oliBrowne/swing-to-mine/docs/architecture.md

# Architecture

How Swing to Mine fits together. This is the **plan**, not a description of finished code: modules listed here may not exist yet. Check each folder's README for status.

## System overview

```mermaid
flowchart LR
    subgraph Handle["Sword handle"]
        IMU["MPU-6050<br/>accel + gyro<br/>100 Hz"]
        BTN["Blue button"]
        LED["4 LEDs"]
    end
    subgraph MCU["STM32F407 firmware"]
        DRV["imu driver<br/>+ calibration"]
        RB["ring buffer<br/>1 s x 6 ch"]
        NN["model runner<br/>int8 CNN"]
        DEC["gesture decoder<br/>thresholds, cooldowns"]
        AIR["air mouse<br/>yaw + pitch"]
        WALK["tilt walk<br/>pitch + roll"]
        MODE["mode manager<br/>LOOK / MOVE / INVENTORY"]
        HID["HID out<br/>keyboard + mouse"]
        CDC["USB serial<br/>data + debug"]
    end
    PC["PC running<br/>Minecraft Java"]
    HOST["host scripts<br/>record, plot"]

    IMU --> DRV --> RB --> NN --> DEC --> MODE
    DRV --> AIR --> MODE
    DRV --> WALK --> MODE
    BTN --> MODE --> LED
    MODE --> HID -->|USB HID| PC
    DRV --> CDC -->|USB serial| HOST
```

Two paths run side by side every sample:

- **ML path:** a sliding window goes through the int8 CNN every 50 ms, and the decoder turns class probabilities into game events (click, hold, jump, scroll, `E`).
- **Direct path:** the gyro and accelerometer drive looking (air mouse) and walking (tilt) with plain math, no ML.

The **mode manager** decides which outputs are live and merges everything into one HID report.

## Modes

```mermaid
stateDiagram-v2
    [*] --> CALIBRATE: power on
    CALIBRATE --> LOOK: still for 2 s
    LOOK --> MOVE: single press
    MOVE --> LOOK: single press
    LOOK --> INVENTORY: hold 1 s (sends E)
    MOVE --> INVENTORY: hold 1 s (sends E)
    INVENTORY --> LOOK: hold 1 s (sends E), back to the last play mode
    INVENTORY --> MOVE: hold 1 s (sends E), back to the last play mode
```

The full control table (every motion and button action per mode), LEDs and the state the firmware tracks: [controls.md](controls.md#quick-reference).

| Mode | Air mouse | Tilt walk | Gestures | LED |
|---|---|---|---|---|
| CALIBRATE | off | off | off | spinning |
| LOOK | left/right + up/down → camera | off | all | green |
| MOVE | left/right only → camera (steering) | tilt from neutral → `WASD` + sprint ([controls.md](controls.md#move-mode-walking-and-sprinting)) | off | orange |
| INVENTORY | left/right + up/down → cursor, low gain | off | paused (button = left click) | blue |

Rules in every mode:

- **Pointing is rate-based, like a Wii remote:** slow rotation moves the camera, a dead zone hides hand shake, and fast rotation freezes the camera because it's probably a gesture ([controls.md](controls.md#pointing-look-mode-and-inventory)). Left/right is turning around the vertical (found from gravity), since the board is held upright.
- **Changing mode releases every held key and click.** Crouch is a `Shift` tap with Minecraft's Sneak set to Toggle, so nothing is held for it ([controls.md](controls.md#crouch)).
- **Rest pose** (board flat or face-down and still for >1 s) pauses all output; the current mode's LED breathes ([LEDs](controls.md#leds)).

## Gestures → game events

| Model class | Motion | Decoder output |
|---|---|---|
| `nothing` | anything else, including slow pointing/looking, resting, fidgeting | none |
| `sword` | side swipe, like swinging a sword | one left click |
| `mine` | continuous chopping (repeated pickaxe swings) | **hold** left click |
| `place` | straight jab forward, no tilt | right click (place block, open chest) |
| `swap_left` | quick hotbar flick to the left | scroll up (one hotbar slot left) |
| `swap_right` | quick hotbar flick to the right | scroll down (one hotbar slot right) |

The model only covers **look mode**. Jump (an upward flick in move mode) and the movement tilts are simple rules in the firmware, so they aren't recorded or trained. Shake was dropped (the button opens the inventory).

**Mine hold logic** (in the decoder, not the model): the model runs continuously on a sliding window, so while you keep chopping it keeps outputting `mine`. The first `mine` starts holding left click; another `mine` within ~600 ms keeps it held; the hold releases after ~400 ms with no more. The camera stays frozen while holding, so the crosshair doesn't drift off the block. A `sword` is a single click and never holds.

Recordings made before Nov 13 used the old names `slash`, `chop`, `punch` (now `sword`, `mine`, `place`); `training/labels.py` has the mapping. Old `hop` and `shake` labels are skipped.

## Timing budget

| Stage | Plan |
|---|---|
| Sampling | 100 Hz, MPU-6050 data-ready interrupt (or its FIFO) |
| Window | 100 samples = 1.0 s, 6 channels |
| Stride | 5 samples = 50 ms (20 inferences/s) |
| Inference | target < 5 ms on the Cortex-M4 |
| Decoder | needs 2–3 agreeing frames → adds 50–100 ms |
| USB | HID poll every 1 ms |
| Air mouse delay | output held back ~60 ms so a starting gesture can cancel it |
| **Target** | **≤ ~100 ms from the gesture's peak to the input** |

Measure with GPIO toggles on a logic analyzer/scope (or 240 fps video), and the DWT cycle counter for inference.

## Memory budget (STM32F407VG: 1 MB flash, 128 KB RAM + 64 KB CCM)

| Item | Estimate |
|---|---|
| Firmware + USB stack | ~60 KB flash |
| Inference runtime (ExecuTorch) | ~50–150 KB flash (unknown: measure early) |
| Model weights (int8) | < 50 KB flash |
| Window buffer | 100 × 6 × int16 = 1.2 KB RAM |
| Model activations | < 32 KB RAM |

DMA can't reach CCM, so keep USB and I2C DMA buffers in normal RAM.

## Interfaces (contracts between parts)

These are the agreements that let firmware, host and training be built in parallel. Change them only with the whole team.

### Sensor units

Raw MPU-6050 counts as `int16`, accel ±16 g (2048 counts/g), gyro ±2000 °/s (16.4 counts per °/s). Axes are the **sensor's** axes; the handle fixes the orientation (see [hardware.md](hardware.md)).

### USB serial stream (data mode)

The board streams one text line per sample at 100 Hz:

```
# swing-to-mine v1 rate_hz=100 accel_fs_g=16 gyro_fs_dps=2000
t_ms,ax,ay,az,gx,gy,gz
12034,-112,2051,48,-3,12,7
```

`t_ms` is board time in milliseconds. Debug/event lines start with `#` so parsers can skip them.

### Recorded data

```
data/raw/<person_id>/<session_id>.csv          # the stream above, as recorded
data/raw/<person_id>/<session_id>.labels.csv   # start_ms,end_ms,label
```

- `person_id` is anonymous: `P01`, `P02`, … (keep the name mapping out of the repo).
- `label` is one of the model classes above. Anything unlabeled counts as `nothing`.
- Sessions are **continuous**: the host script shows a cue, the person performs the gesture somewhere inside normal movement, and the label marks roughly where it happened. Training refines the label to the motion peak.

### Model input and output

- Input: `int8 [1, 6, 100]` (channels × time), scaled with fixed per-channel constants saved next to the model.
- Output: `int8/float [1, 8]` scores in the class order of the gestures table above.
- The class list lives in one place: `training/labels.py` (planned) and is mirrored in firmware by the export step.

## Toolchain (pin versions when first installed)

| Part | Tool |
|---|---|
| Firmware | CMake + Arm GNU toolchain (`arm-none-eabi-gcc`), ST HAL/CMSIS as git submodules (no CubeIDE needed) |
| Flashing | OpenOCD over the onboard ST-LINK (planned) |
| USB | TinyUSB (composite HID keyboard + mouse with report IDs, plus CDC serial). Fallback: pick HID or serial at boot |
| Inference | ExecuTorch (same flow as Lab 3). Fallback: TFLite Micro or hand-written int8 CNN with CMSIS-NN |
| Training | Python 3, PyTorch, NumPy, pandas |
| Host | Python 3, pyserial, matplotlib |

## Decisions log

| Date | Decision | Status |
|---|---|---|
| Oct 25 | No keyboard or mouse: the board does everything | ✅ decided |
| Oct 25 | MPU-6050 for both gyro and accel (onboard LIS3DSH unused) | ✅ decided |
| Oct 26 | Look/move switch is a **toggle** (short press) | ✅ decided |
| Oct 26 | Target Minecraft **Java Edition** | ✅ decided (confirm demo laptop has it) |
| Oct 26 | Sword + mine merged into one "strike" behavior in the decoder | 🟡 proposed default |
| Oct 26 | ~~Shake = `E` + CURSOR mode~~ replaced Nov 12 by the button; recipe book for crafting | superseded |
| Oct 26 | Jump = hop only, Auto-Jump on | 🟡 proposed default |
| Oct 26 | Fallback if behind: real keyboard for walking | 🟡 proposed default |
| Nov 12 | Button: single press = move/look, hold 1 s = open/close inventory, double press = crouch (taps `Shift`, game's Sneak set to Toggle); in the inventory a press = left click, gestures paused ([controls.md](controls.md)) | ✅ decided |
| Nov 12 | Board held upright; move mode zeroes its neutral angle on entry and turns gestures off; recordings use the upright grip ([controls.md](controls.md#quick-reference)) | ✅ decided |
| Nov 12 | Sprint = steep forward tilt (~40°, held ~0.3 s) in move mode, stays on until level; angles to tune ([controls.md](controls.md#move-mode-walking-and-sprinting)) | ✅ decided |
| Nov 12 | Hold 3 s = resync when board and game disagree (e.g. after opening a chest); LED scheme in [controls.md](controls.md#leds) | ✅ decided |
| Nov 12 | Auto recalibrate in rest pose ([controls.md](controls.md)) | 🟡 proposed default |
| Nov 12 | Until USB serial works (M3), record data over USART2 (PA2/PA3) + a USB-UART adapter at 115200 baud, same text format ([wiring.md](wiring.md)) | 🟡 proposed default |

Background for these: [council-review.md](council-review.md).
