oliBrowne/swing-to-mine/docs/gesture-notes.md

# Gesture notes

Working notes on the control scheme and the gesture dataset. Anything marked **open** still needs a team decision.

## Control scheme

The board is the whole controller: no keyboard or mouse.

### Button (blue user button)

Moved to [controls.md](controls.md) (Nov 12): single press = switch move/look, hold 1 s = open/close the inventory, double press = crouch.

The LEDs show the current mode (green = look, orange = move, blue = inventory).

### Gestures (look mode only since Nov 12; switched off in move mode, see [controls.md](controls.md#move-mode-walking-and-sprinting))

| Gesture | Motion | Input sent |
|---|---|---|
| Swing sword | One sharp slash | Left click |
| Mine | Keep chopping | Hold left click |
| Place block | Punch forward | Right click |
| Jump | Hop, or flick up | `Space` |
| Swap item left / right | Twist wrist left / right | Scroll wheel up / down |
| Nothing | Any other motion | Nothing |

Sword vs. mine is the hardest pair: Minecraft sees both as a left click, so the model has to tell one slash from repeated chopping.

### Look mode: "air mouse"

- Works like a Wii remote: the gyro measures how fast the board rotates, and that becomes mouse movement. Turn slowly and the camera pans slowly; stop and it stops. Details and thresholds: [controls.md](controls.md#pointing-look-mode-and-inventory).
- The board never needs to know where the screen is, only how it turns. That avoids the "where is the player's eye relative to the board" problem.
- **Calibration:** on startup, hold the board still for 1–2 s so the firmware can measure the gyro's built-in drift and subtract it.
- **Swing fix:** a sword swing also rotates the board. Aiming pauses whenever the model detects a gesture, or when the board spins faster than a threshold, so the camera doesn't jerk.

### Move mode: tilt to walk (default)

| Option | How it works | Pros | Cons |
|---|---|---|---|
| **Tilt to walk** (suggested first) | Board acts as a joystick: tilt forward = walk, back = back up, sideways = strafe | Simple, reliable, no ML | Less impressive |
| Walk in place | March on the spot; a model detects "walking" from the bobbing and you walk where you're looking | Great demo, real ML | Needs a way to stop and to strafe |
| Point and go | Walk in whatever direction the board points | Intuitive | Hard to aim and move at once |

Plan: start with tilt-to-walk so the checkpoint has a working controller, then try walk-in-place as an ML stretch goal. In move mode, turning the board left/right still steers the camera; only tilt becomes `WASD`.

> **Updated Oct 26 after the [council review](council-review.md):** sword + mine become one "strike" behavior (click, then hold while striking), jump is a hop only, and shake (`E` + cursor mode) is a must-have. The current gesture list lives in [architecture.md](architecture.md#gestures--game-events).

Sprint is a steeper forward tilt in move mode (decided Nov 12, [controls.md](controls.md#move-mode-walking-and-sprinting)).

## Gyro

We're using an **MPU-6050 (GY-521 breakout)**: cheap, very well documented, and it adds the rotation data that separates twist from punch and slash from chop. See [hardware.md](hardware.md) for parts and wiring.

- Set the gyro to its **±2000 °/s** range, because a hard swing can max out the lower ranges.
- Cheap GY-521 boards often use clone chips, so `WHO_AM_I` may not return `0x68`. Don't fail on it.
- Use the MPU's own accelerometer instead of the onboard LIS3DSH, so all 6 channels come from one chip at the same moment (one 14-byte I2C read at 100 Hz).
- **Mount it rigidly** (solder or hot glue). Jumper wires pop out when you swing the board, and a sensor that shifts between sessions changes the data.
- Possible upgrades: an ST LSM6DSOX / LSM6DS3 breakout (newer, lower noise) or a BNO085 (computes orientation for you, which makes aiming easier).

## Data collection plan

**Target: about 40 reps per gesture per person, from at least 4–5 people (about 200 examples per gesture).** For reference, the Lab 2 dataset used 140 per gesture from 7 people and reached about 95%. Our 6 channels should make these gestures easier to tell apart.

| Class | Per person | How to record |
|---|---|---|
| Swing sword | 40 | One slash per clip |
| Place block | 40 | One punch per clip |
| Jump | 40 | Mix hops and flicks |
| Swap left | 40 | Separate class from swap right |
| Swap right | 40 | Separate class from swap left |
| Mine | 20 clips | Chop continuously for 3–4 s per clip |
| **Nothing** | **about 10 minutes** | Aiming, tilt-walking, resting, scratching your head, sitting down |

That's about 25 minutes of recording per person, in one sitting.

### Why "nothing" matters most

The model runs constantly on live motion, so most of what it sees isn't a gesture. Without plenty of random everyday movement in the data, it will keep firing gestures by accident.

### Tips

- **Vary each gesture:** soft and hard, fast and slow, standing and sitting. Keep the **same grip** every time: the board **upright**, like a sword handle (decided Nov 12, [controls.md](controls.md#quick-reference)).
- **Test on someone new:** keep one person's data completely out of training and test on it. That shows the model works for a person it has never seen, which is what the live demo needs.
- **If it's only Oliver and Eli:** do about 60 reps each and lean on augmentation, but try to recruit 2–3 friends for 25 minutes each.
- Data comes off the board through the USB serial mode on the micro-USB port (no UART adapter needed). Until that works, use the UART adapter: see [wiring.md](wiring.md).
