oliBrowne/swing-to-mine/docs/proposal/swing-to-mine-proposal.pptx

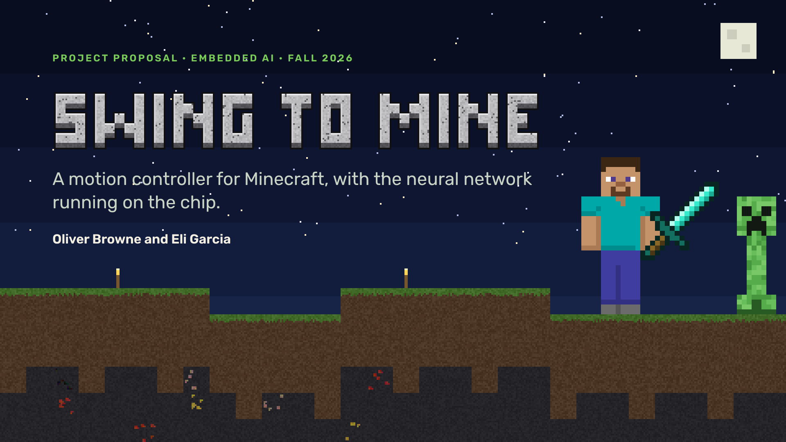
[picture p1: figure]

Notes: OLIVER: Hi, we’re Oliver and Eli. Our project is Swing to Mine, a motion controller for Minecraft. This is our plan. Nothing is built yet.

## Slide 2

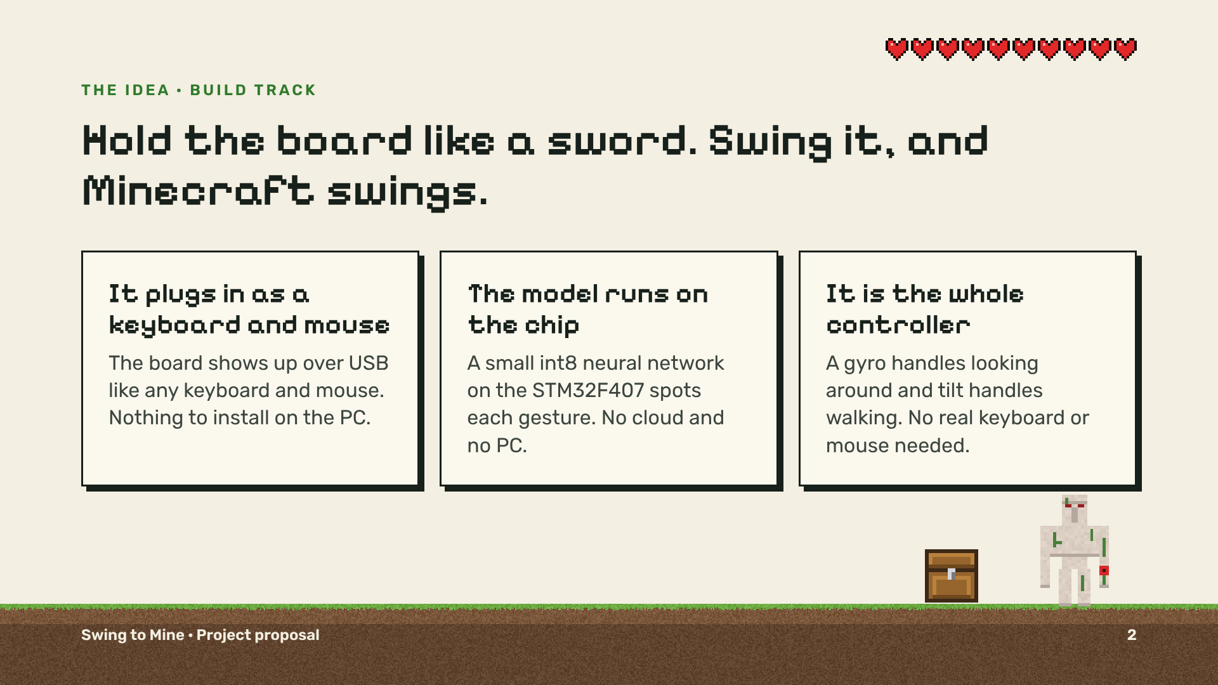
[picture p2: figure]

Notes: OLIVER: You hold an STM32 Discovery board like a sword. Swing it, and your character swings. The board plugs in as a normal USB keyboard and mouse, so there’s nothing to install. A small neural network on the chip recognizes each gesture. And the board is the whole controller.

## Slide 3

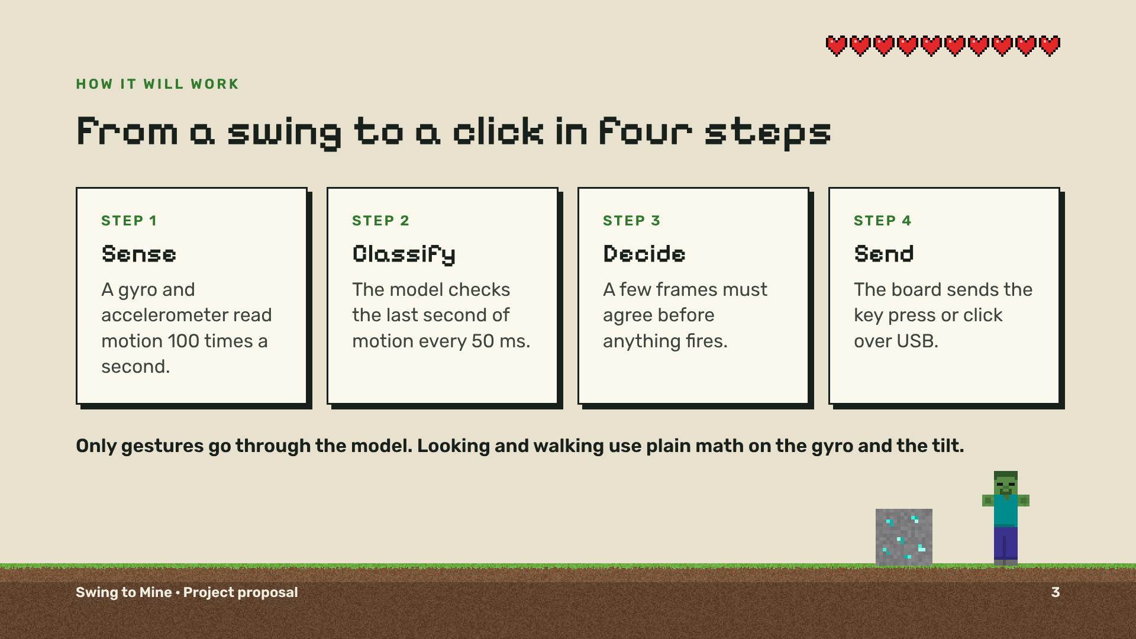
[picture p3: figure]

Notes: OLIVER: Here’s how it will work. A gyro and accelerometer read motion a hundred times a second. The model checks the last second of motion every fifty milliseconds. A few frames have to agree before anything fires. Then the board sends the click over USB.

## Slide 4

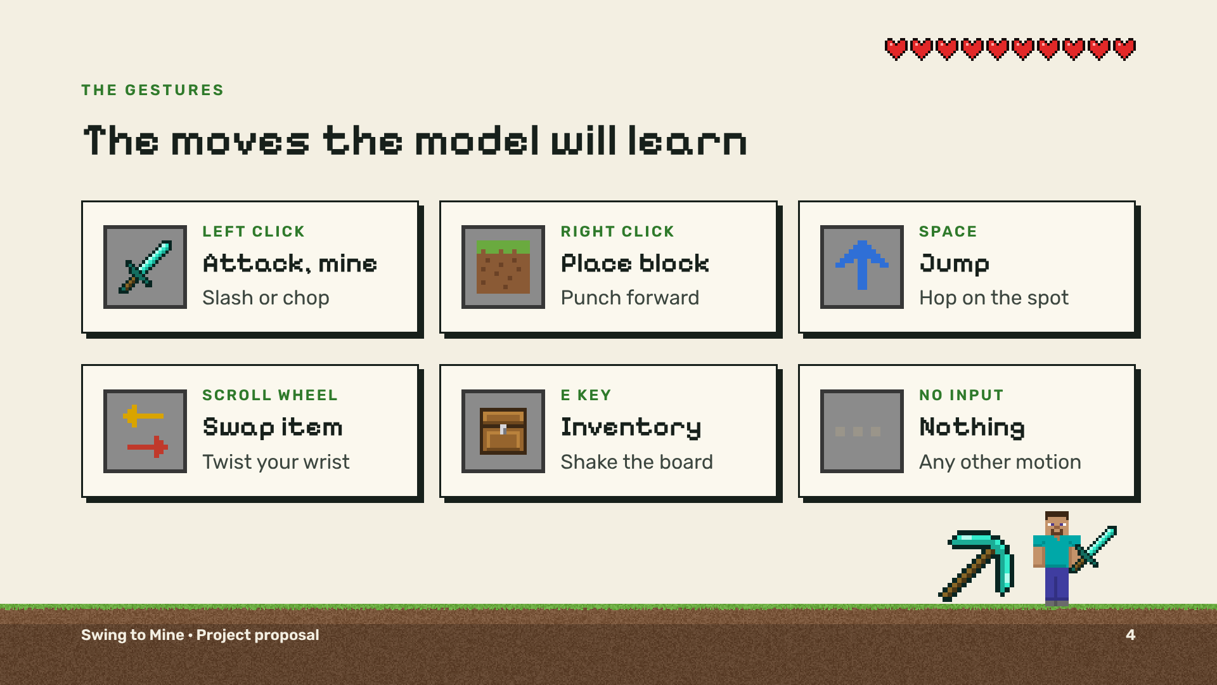
[picture p4: figure]

Notes: OLIVER: These are the moves. Slash or chop to attack, and keep striking to mine. Punch to place a block. Hop to jump. Twist to swap items. Shake for the inventory. Everything else has to count as nothing.

## Slide 5

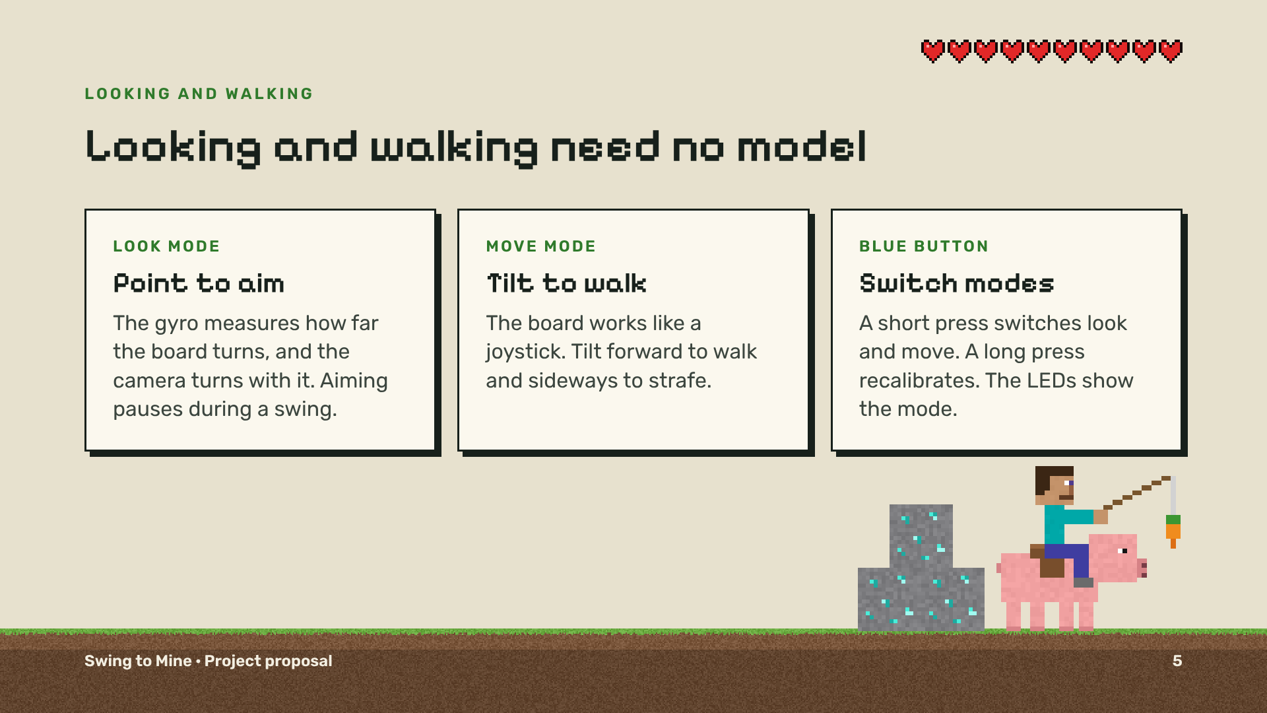
[picture p5: figure]

Notes: OLIVER: Looking and walking don’t use the model. The gyro works like an air mouse for aiming, and tilting the board walks. The blue button switches between the two. Over to Eli.

## Slide 6

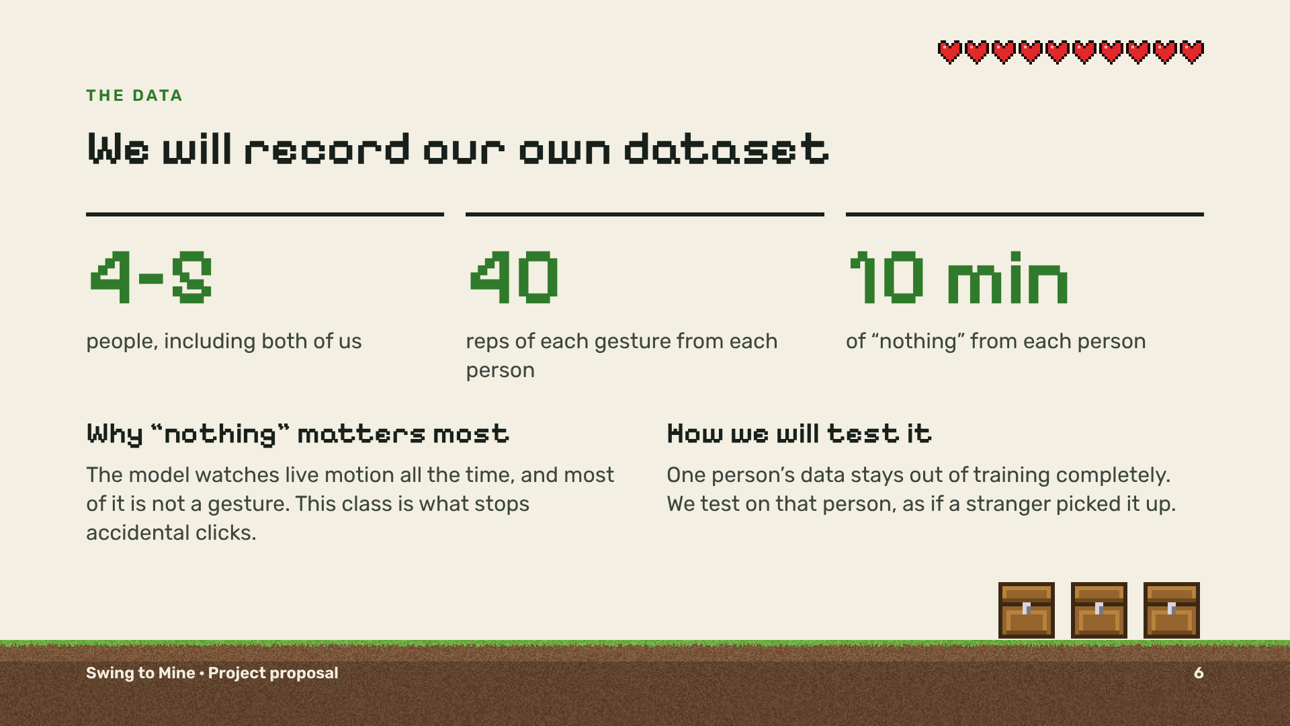
[picture p6: figure]

Notes: ELI: We’ll record our own data, like in Lab 2. Four or five people, forty reps of each gesture, plus ten minutes each of just moving around. That “nothing” data is what stops accidental clicks. We’ll test on a person the model has never seen.

## Slide 7

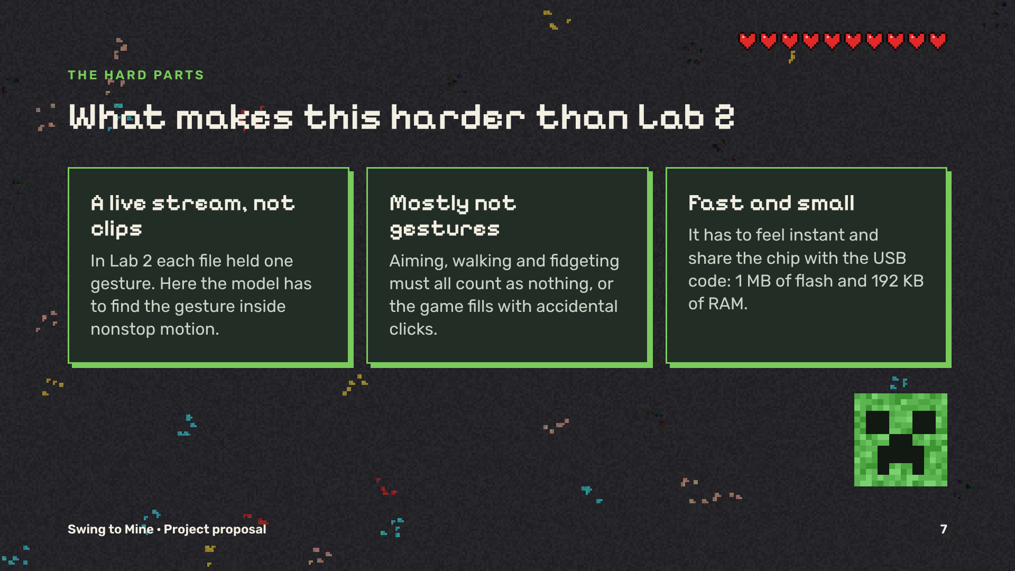
[picture p7: figure]

Notes: ELI: It’s harder than Lab 2 for three reasons. The model sees a live stream, not neat clips. Most motion isn’t a gesture. And it has to be fast and fit on the chip.

## Slide 8

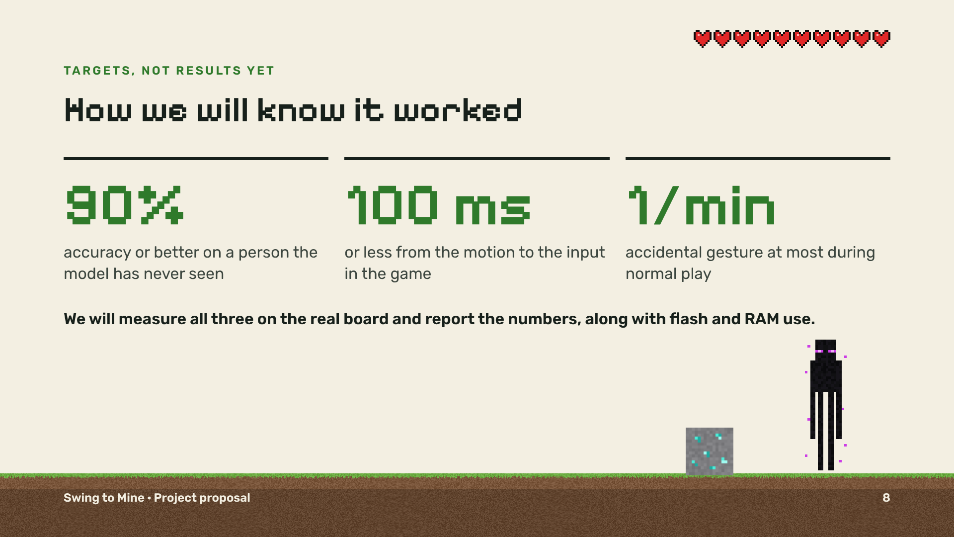
[picture p8: figure]

Notes: ELI: Our targets: ninety percent accuracy on a new person, a tenth of a second from motion to input, and at most one accidental gesture a minute. We’ll measure all three on the real board.

## Slide 9

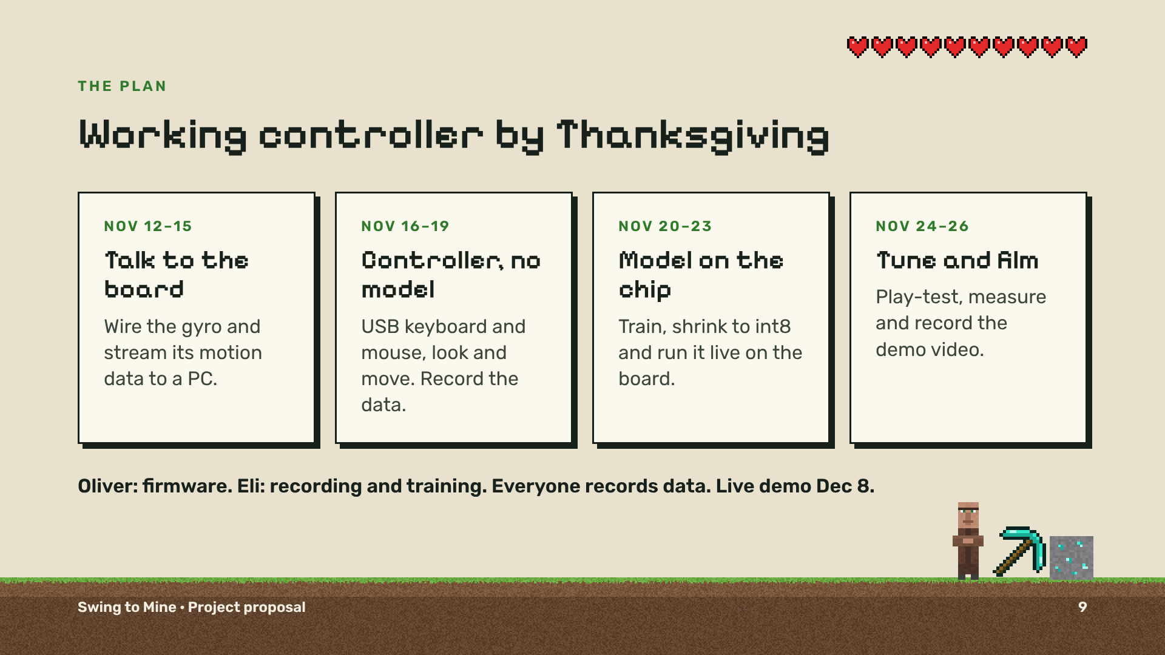
[picture p9: figure]

Notes: ELI: We want it working by Thanksgiving. First, get data off the board. Then a working controller with no model. Then the model on the chip. Then tuning and a demo video. Oliver does the firmware, and I do the recording and training.

## Slide 10

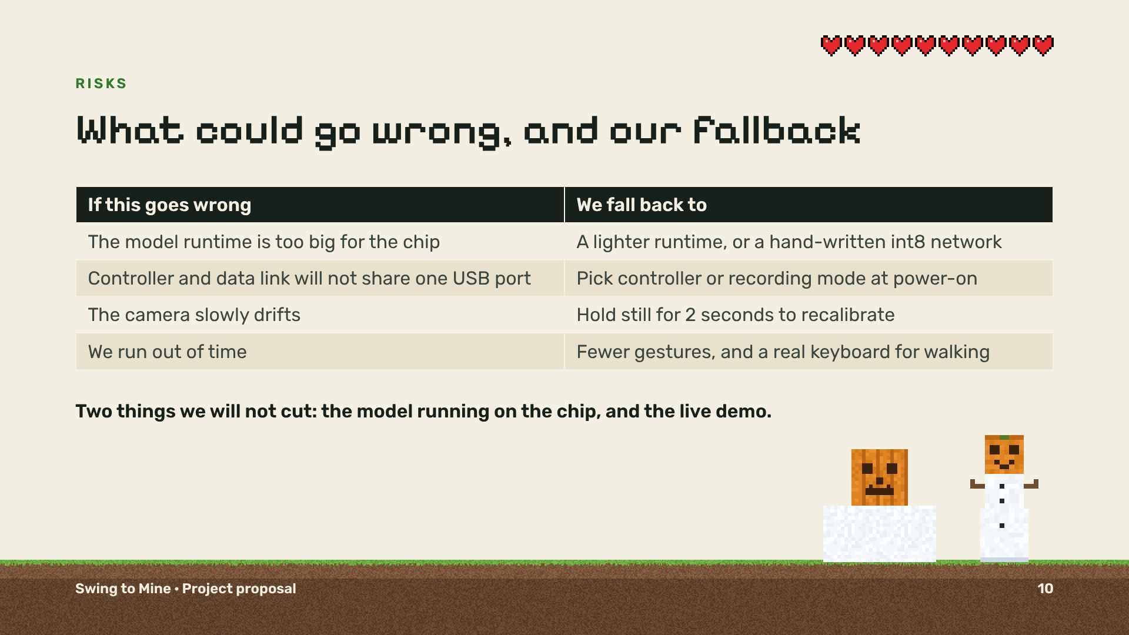
[picture p10: figure]

Notes: ELI: The biggest risk is the model runtime not fitting on the chip, so we have a lighter backup. If we run short on time, we cut gestures and use a real keyboard for walking. The on-chip model and the live demo stay.

## Slide 11

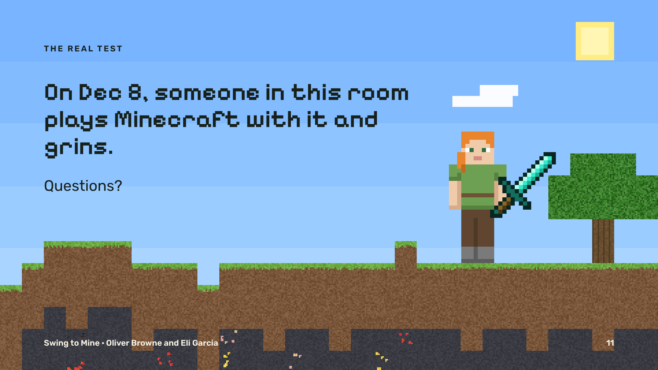
[picture p11: figure]

Notes: OLIVER: The real test is December eighth: one of you plays Minecraft with it and grins. Questions?
