oliBrowne/swing-to-mine/docs/proposal/README.md

# Checkpoint proposal (Nov 2026)

The class presentation pitching Swing to Mine before anything was built.

- [swing-to-mine-proposal.pdf](swing-to-mine-proposal.pdf): the 11 slides
- [swing-to-mine-proposal.pptx](swing-to-mine-proposal.pptx): the same slides for PowerPoint, as pictures with the script in the speaker notes
- [script.md](script.md): a three minute script, one part per slide

Everything in it is a plan and a set of targets, not results. The pixel art is hand-drawn in the style of Minecraft and is not official Mojang art.
