oliBrowne/swing-to-mine/(commit log)

2026-10-25 Initial project setup: README, graphics, pitch and folder layout
2026-10-25 Add MPU-6050 gyro parts list and wiring
2026-11-12 Add data capture: MPU-6050 firmware, record.py and wiring guide
2026-11-12 Add PowerPoint version of the proposal slides
2026-11-12 Add button controls spec: move/look, inventory hold, crouch
2026-11-12 Controls: 3 s resync decided, LED scheme
2026-11-13 Add driver and COM port setup guide for the UART adapter and ST-LINK
2026-11-13 Add Windows quick start to driver setup guide
2026-11-13 Update gesture list to sword, mine, place, swap left/right
    record.py was still cueing the old October classes (slash, chop, punch,
    hop, shake). The model now covers look mode only: sword (side swipe),
    mine (pickaxe arc), place (straight jab, no tilt), hotbar flick left/right,
    and nothing. Old label names map via OLD_NAMES in training/labels.py.
    [record.py]
2026-11-13 Simplify sword cue to just 'side swipe'
    The 'board stays upright' wording was confusing during recording.
2026-11-13 First sesssion of data (s01)
    [s01.csv, s01.labels.csv]
2026-11-13 s02 data sent, Oliver
    [s02.csv, s02.labels.csv]
2026-11-13 new data s03 (Eli)
    [s03.csv, s03.labels.csv]
2026-11-13 s04 data (ELI)
    [s04.csv, s04.labels.csv]
2026-11-13 Repair P01/s04 timestamps
    The board restarted twice during s04 (clock went back to 0 at the start of
    rounds 3 and 4) and two timestamps were garbled. Times are shifted so they
    keep counting up, and the labels get the same shift per round. Sensor
    readings are unchanged.
    [s04.csv, s04.labels.csv]
2026-11-13 all new data for lots
    [s05.csv, s05.labels.csv, s06.csv, s06.labels.csv, s07.csv, s07.labels.csv, s08.labels.csv, s09.csv]
2026-11-13 Stop recording when the board stops sending; clean up broken sessions
    record.py: if no sample arrives for 1 s, it stops cueing with a big warning
    instead of writing labels that have no data. If the board never sends
    anything, the empty session files are deleted.
    Data: remove 6 empty sessions (P02 s08, s11-s14, P03 s15) and drop labels
    recorded after the board stopped in P02/s10 (7), P02/s15 (25) and
    P03/s16 (67).
    [s08.labels.csv, s10.labels.csv, s11.labels.csv, s12.labels.csv, s13.labels.csv, s14.labels.csv, s15.labels.csv, s16.labels.csv]
2026-11-13 Add --look-minutes: idle recording while looking around
    Prints a new look-around prompt every 4-8 s so the idle data has normal
    aiming motion instead of a board held dead still. No labels are written,
    so the whole session counts as 'nothing'.
2026-11-13 Run the gesture model on the board: int8 ExecuTorch + CMSIS-NN in 3.4 ms
    - training/export.py: int8 (CortexMQuantizer, CMSIS-NN ops) or --float export,
    plus one real test window per gesture with the expected scores
    - firmware/model_test: speed-test firmware (DWT timing, results read over the
    ST-LINK), patched avg_pool2d op for the M4, ExecuTorch build/flash/readback scripts
    - docs/results.md: measured 152 -> 64.5 -> 64.0 -> 21 -> 3.43 ms, flash, RAM,
    int8 vs float accuracy on unseen people
    - READMEs: status, M4 milestone
2026-11-13 Max pooling over time: 95.5 -> 96.3% on unseen people, 3.41 ms on the board
    - training/model.py: pool option (max, avg, avgmax), default max; load_checkpoint()
    keeps old checkpoints (no pool entry) loading as average pooling
    - train.py: --pool, saved in the checkpoint; export.py: MaxPool2d for int8
    - docs/results.md: architecture sweep (3 seeds, +-0.5 spread, 2 test people) and
    the new board numbers (3.41 ms, 116,912 B flash, int8 = float on unseen people)
    - .gitattributes: keep .sh files LF so the scripts run in WSL from a Windows checkout
2026-11-13 Add firmware/live_test: MPU-6050 -> int8 model every 50 ms -> LEDs (untested with a sensor)
    Built and flashed on a board without an MPU-6050 (WHO_AM_I 0xFF, waits with
    the red LED on). Live inference, decoder and LEDs have not run with a sensor yet.
    - src/imu.c: capture's I2C/MPU-6050 driver for the 42 MHz bus clock
    - src/main.cpp: 1 s ring buffer scaled like dataset.py, model every 50 ms,
    decoder (p >= 0.8 twice in a row, 500 ms cooldown, mine held while winning)
    - scripts/watch.py: status over the ST-LINK; --seconds 120 counts false triggers
    - README: LED meanings, build/flash steps, what to try
2026-11-14 Replay recordings like the board would; decoder that catches 96.7% of gestures instead of 90.9%
    - training/evaluate_stream.py: model every 50 ms over whole sessions of an unseen
    person + the decoder; counts hits, misses, double fires, wrong gestures and
    false triggers per minute
    - decoder: confidence >= 0.60 three runs in a row, 300 ms cooldown, a fired
    gesture must stop winning before it can fire again, mine released after 400 ms
    - firmware/live_test: same decoder in C++ (identical events to the Python one on
    11 replayed sessions; not built or flashed yet)
    - docs/results.md: replay table
    [main.cpp]
